abhi11796acharya/GHPowermon_new/Documents/progress-presentation/GHpowermonitoring.pdf

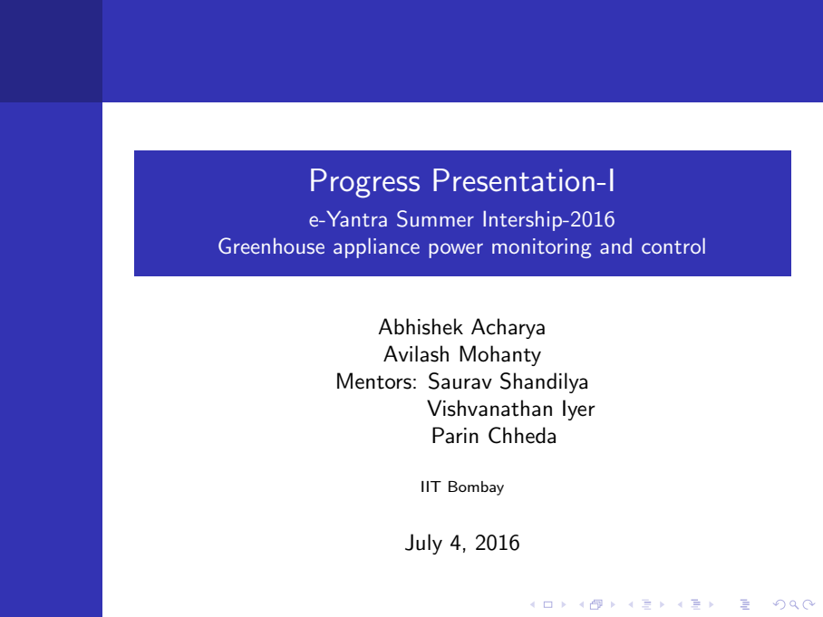
[picture p68: figure]
Progress Presentation-I; e-Yantra Summer Intership-2016; Abhishek Acharya Avilash Mohanty Mentors: Saurav Shandilya Vishvanathan Iyer Parin Chheda; IIT Bombay; July 4, 2016

# Greenhouse appliance power monitoring and control

Progress
Presentation-I

Abhishek
Acharya
Avilash Mohanty
Mentors: Saurav
Shandilya

Vishvanathan
Iyer

Parin Chheda

Overview of
Project

Overview of Task

Task Accomplised

Challenges Faced

Future Plans

References

Thank You

# Overview of Project

# Project Name: Greenhouse appliance power monitoring and control

# Objective: To develop a wifi enabled device which will measure and display the basic and derived inflow parameters of connected electrical appliance on the web page. Device should be capable

of turning on/off the electrical appliance from web user interface.

# Deliverables: A system which:

# Log and display measured electrical parameters on web server

and page.
control appliance from web user interface.

# schedule on/off time of appliance based on power consumption

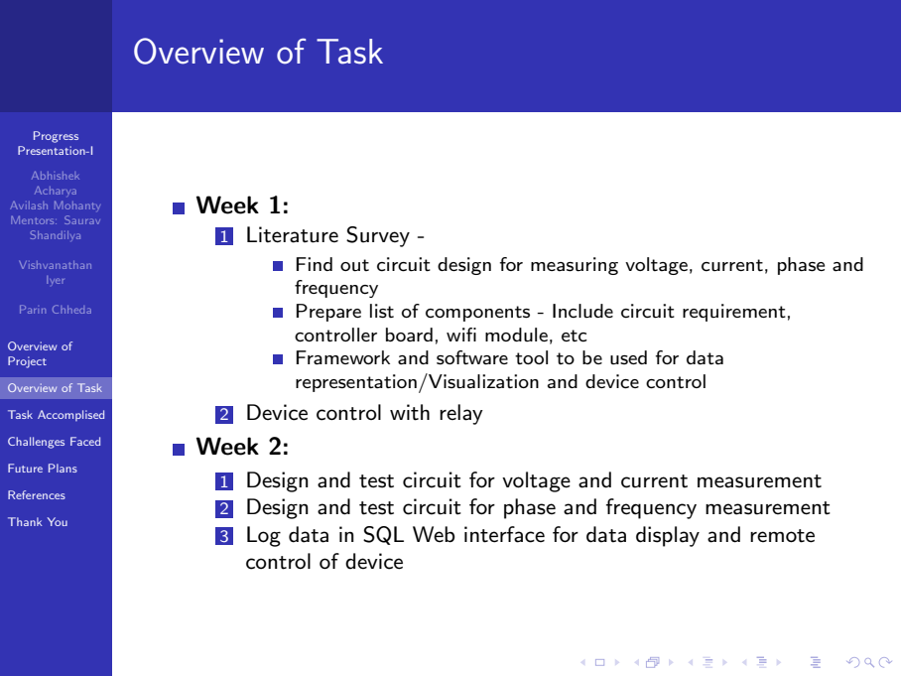
[picture p69: figure]
Progress Presentation-I; Abhishek Acharya Avilash Mohanty Mentors: Saurav Shandilya; Vishvanathan Iyer; Parin Chheda; Overview of Project; Overview of Task; Task Accomplised; Challenges Faced; Future Plans; References; Thank You; Week 1:; Literature Survey -; frequency; controller board, wifi module, etc; Device control with relay; Week 2:; control of device

## Find out circuit design for measuring voltage, current, phase and

Prepare list of components - Include circuit requirement,

## Framework and software tool to be used for data representation/Visualization and device control

1 | Design and test circuit for voltage and current measurement
2 | Design and test circuit for phase and frequency measurement
3 | Log data in SQL Web interface for data display and remote

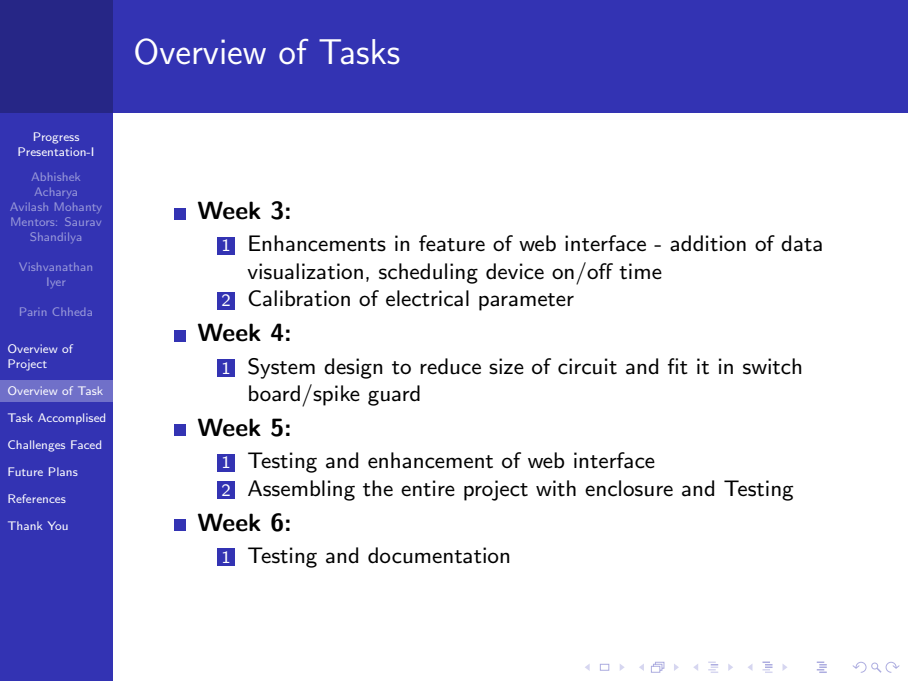
[picture p70: figure]
Progress Presentation-I; Abhishek Acharya Avilash Mohanty Mentors: Saurav Shandilya; Vishvanathan Iyer; Parin Chheda; Overview of Project; Overview of Task; Task Accomplised; Challenges Faced; Future Plans; References; Thank You; Overview of Tasks; Week 3:; Calibration of electrical parameter; Week 4:; board/spike guard; Week 5:; Week 6:; Testing and documentation

1 | Enhancements in feature of web interface - addition of data visualization, scheduling device on/off time
1 | System design to reduce size of circuit and fit it in switch
1 | Testing and enhancement of web interface
2 | Assembling the entire project with enclosure and Testing

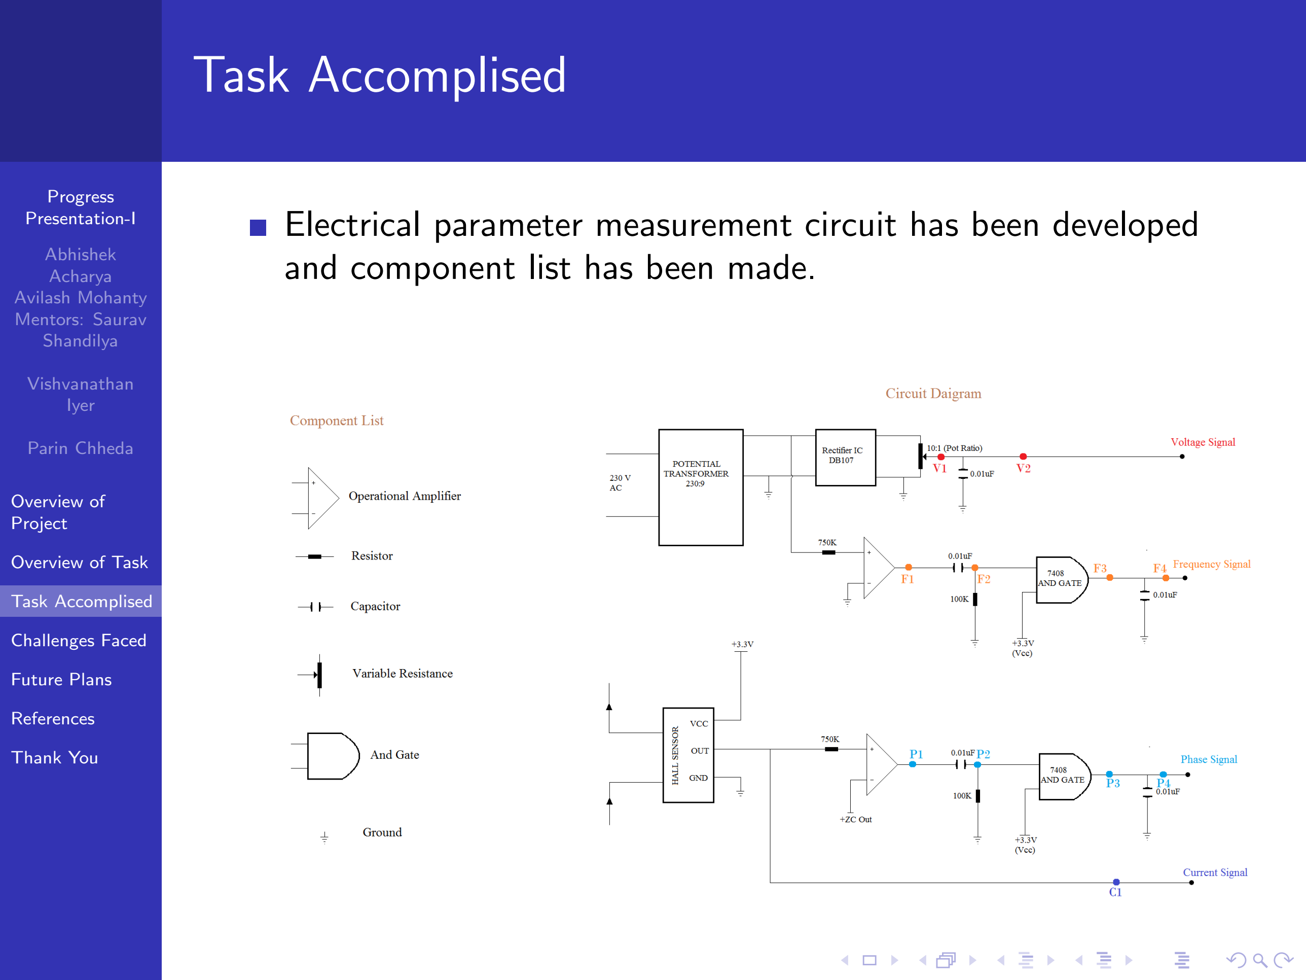
[picture p71: figure]
Progress Presentation-I; Abhishek Acharya Avilash Mohanty Mentors: Saurav Shandilya; Vishvanathan Iyer; Parin Chheda; Overview of Project; Overview of Task; Task Accomplised; Challenges Faced; Future Plans; References; Thank You; and component list has been made.

# Electrical parameter measurement circuit has been developed

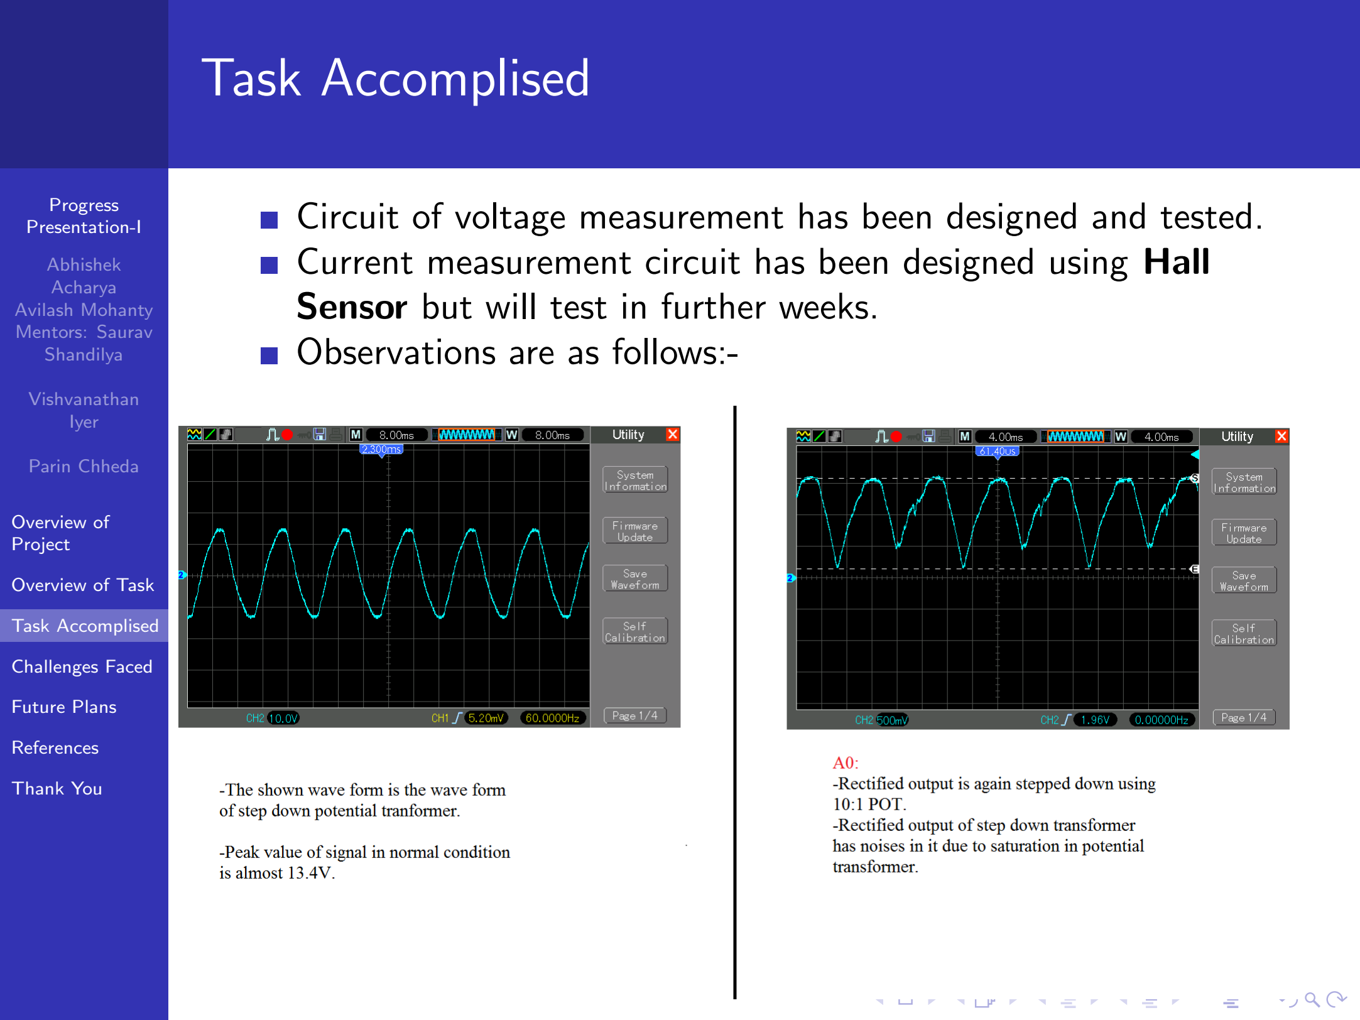
[picture p72: figure]
Progress Presentation-I; Abhishek Acharya Avilash Mohanty Mentors: Saurav Shandilya; Vishvanathan Iyer; Parin Chheda; Overview of Project; Overview of Task; Task Accomplised; Challenges Faced; Future Plans; References; Thank You; Sensor but will test in further weeks. Observations are as follows:-

Circuit of voltage measurement has been designed and tested.

# Current measurement circuit has been designed using Hall

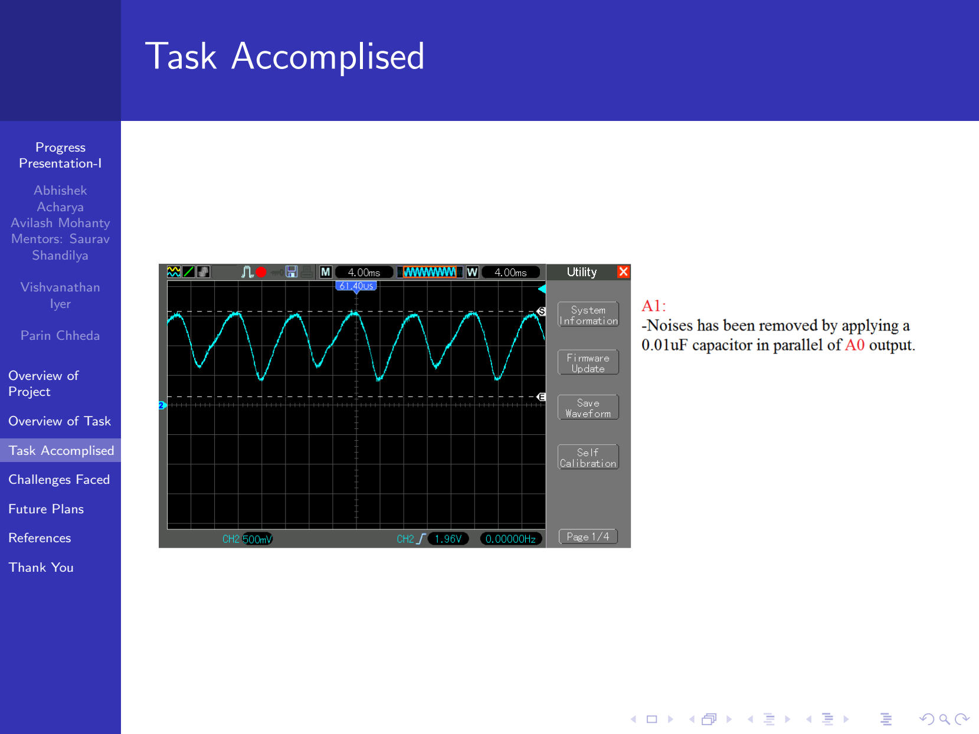
[picture p73: figure]
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

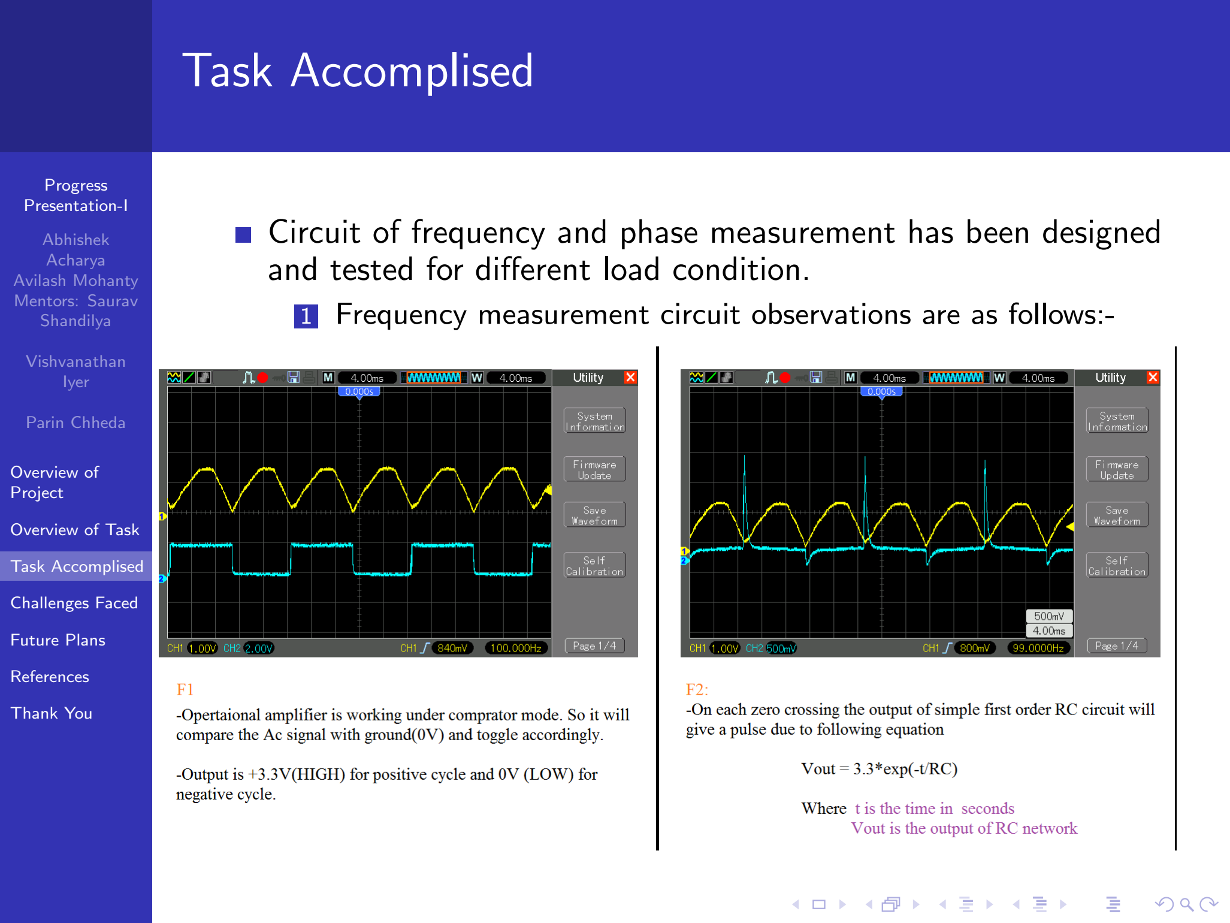
[picture p74: figure]
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

# Circuit of frequency and phase measurement has been designed

and tested for different load condition.

# 1 Frequency measurement circuit observations are as follows:-

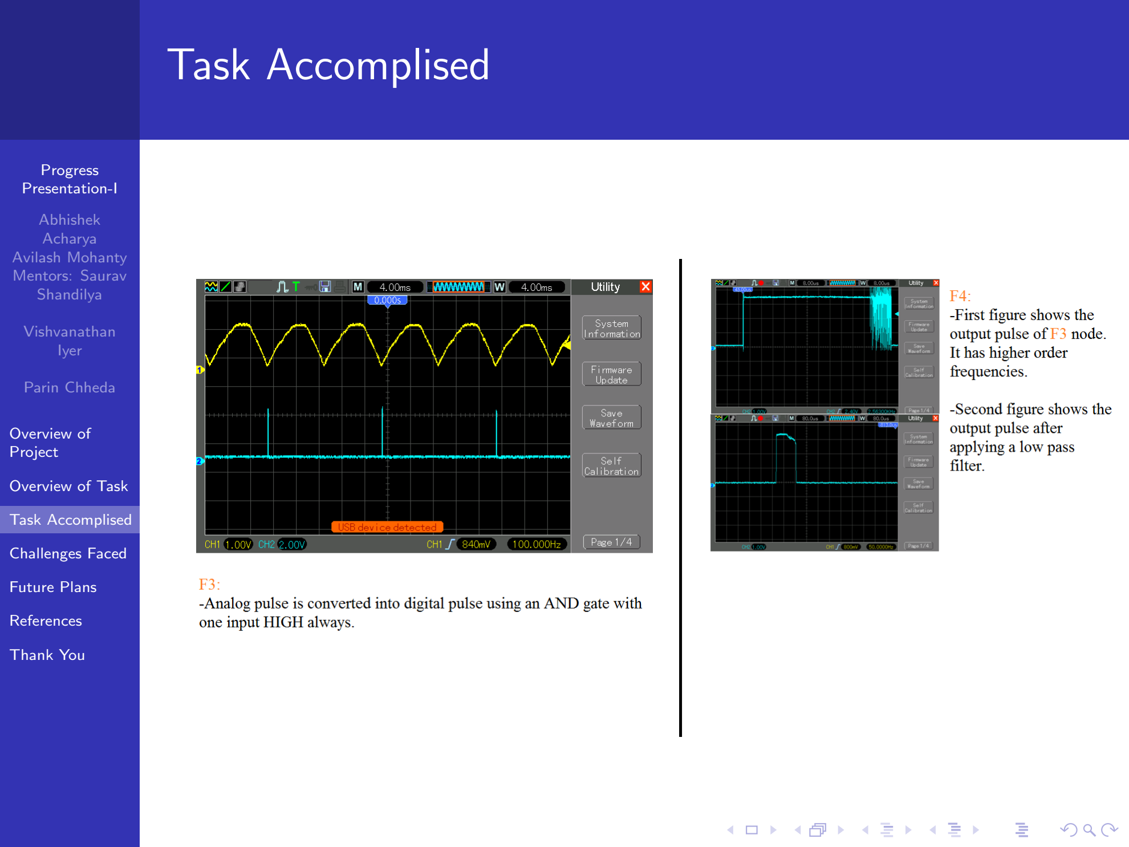
[picture p75: figure]
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

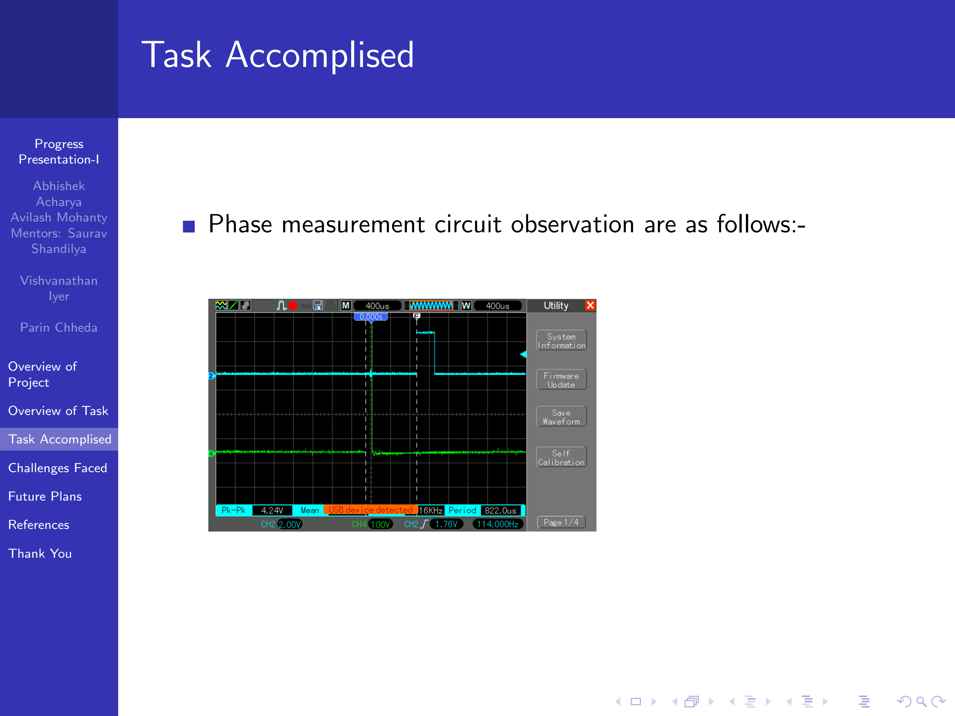
[picture p76: figure]
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

# Phase measurement circuit observation are as follows:-

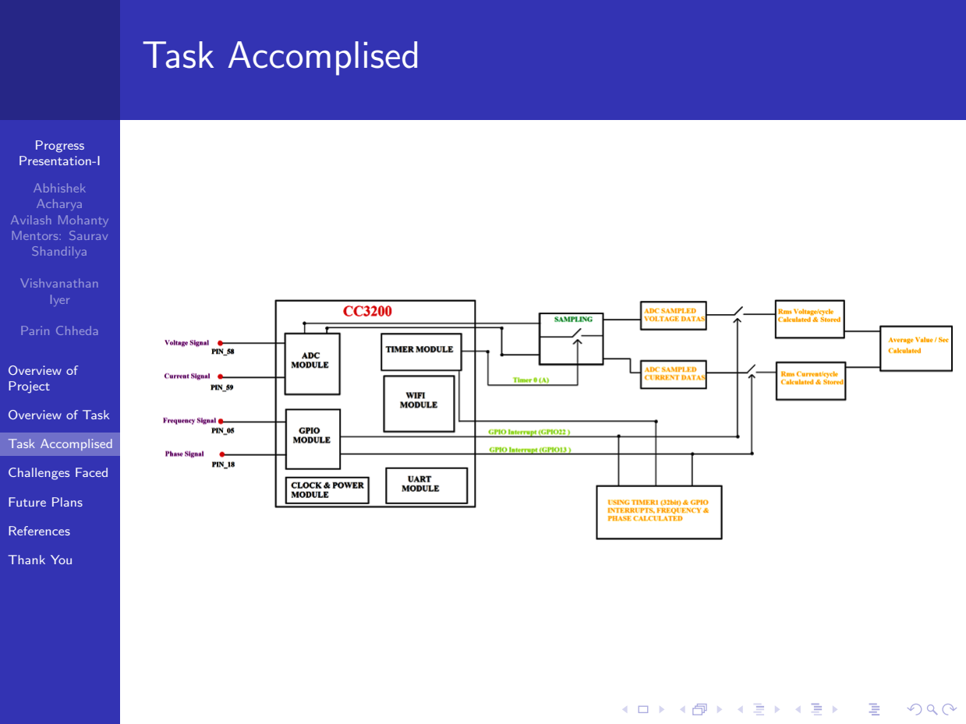
[picture p77: figure]
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

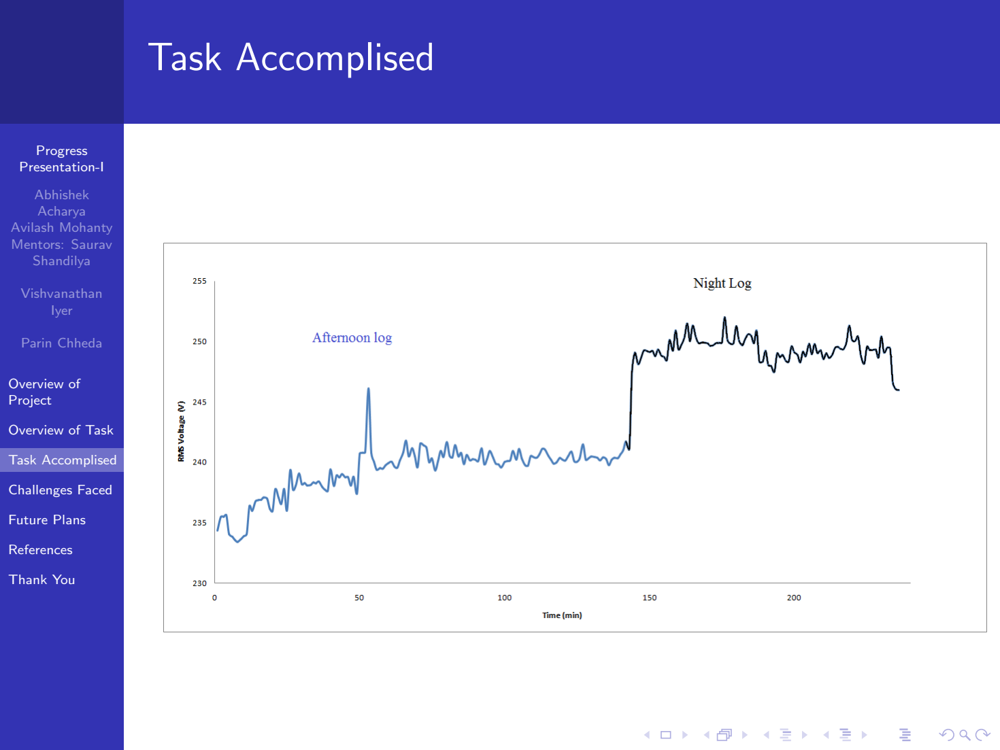
[picture p78: figure]
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

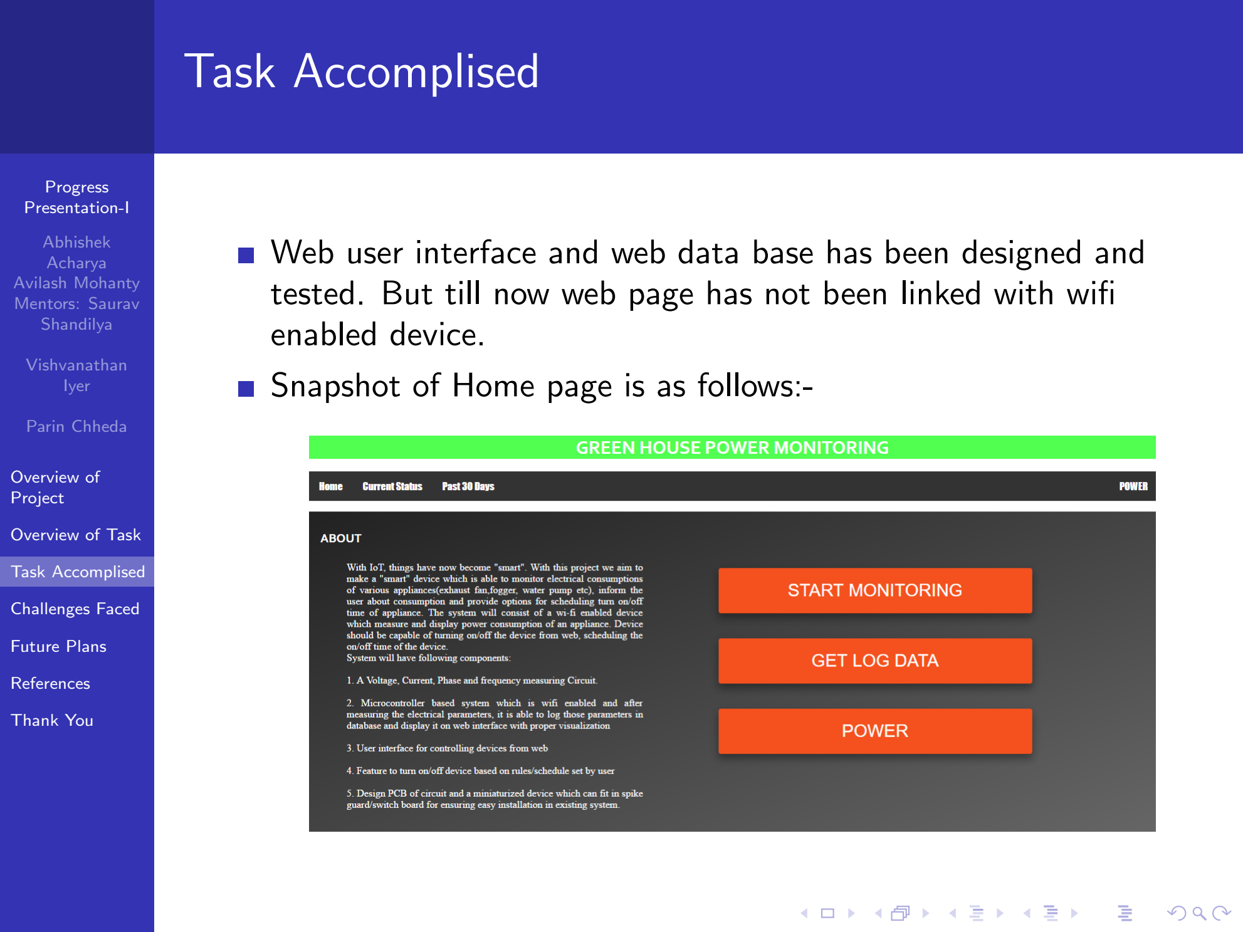
[picture p79: figure]
Progress Presentation-I; Abhishek Acharya Avilash Mohanty Mentors: Saurav Shandilya; Vishvanathan Iyer; Parin Chheda; Overview of Project; Overview of Task; Task Accomplised; Challenges Faced; Future Plans; References; Thank You; enabled device.; Snapshot of Home page is as follows:-

# Web user interface and web data base has been designed and tested. But till now web page has not been linked with wifi

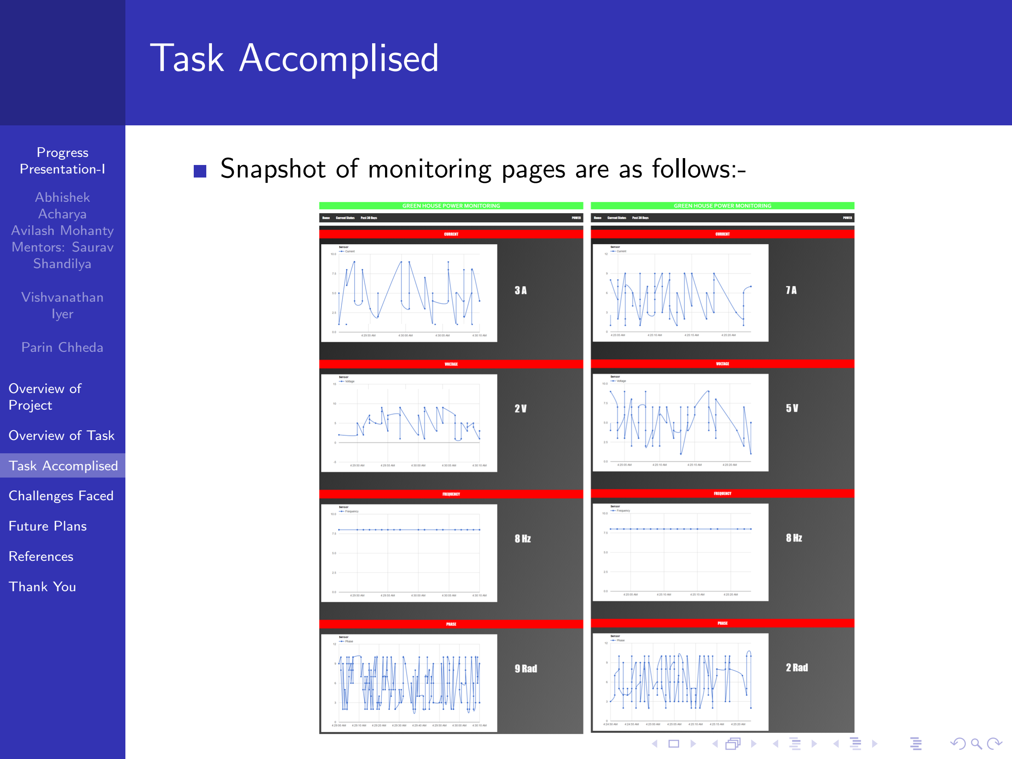
[picture p80: figure]
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

# Snapshot of monitoring pages are as follows:-

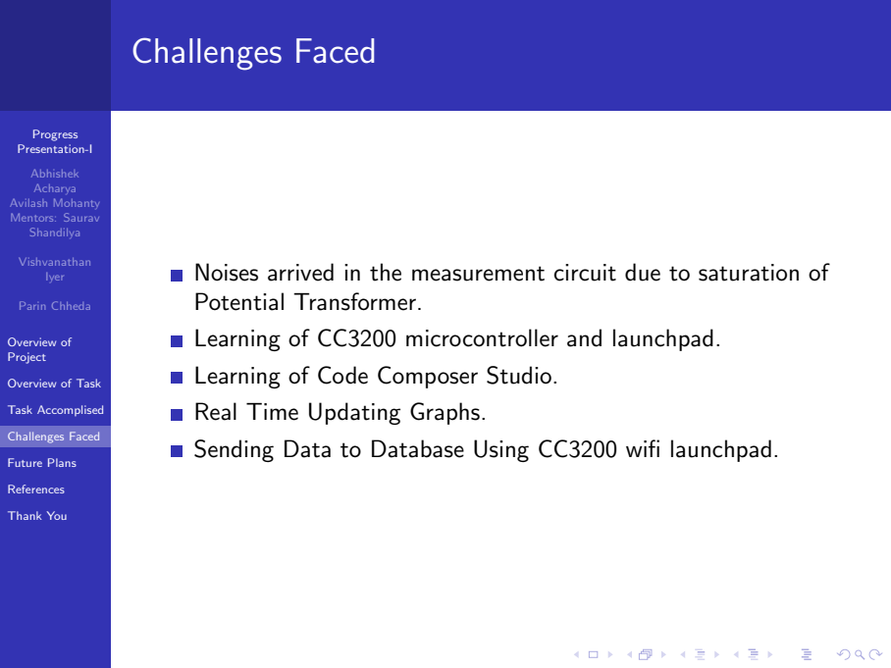
[picture p81: figure]
Progress Presentation-I; Abhishek Acharya Avilash Mohanty Mentors: Saurav Shandilya; Vishvanathan Iyer; Parin Chheda; Overview of Project; Overview of Task; Task Accomplised; Challenges Faced; Future Plans; References; Thank You; Potential Transformer.; Learning of Code Composer Studio.; Real Time Updating Graphs.

# Noises arrived in the measurement circuit due to saturation of

Learning of CC3200 microcontroller and launchpad.

Sending Data to Database Using CC3200 wifi launchpad.

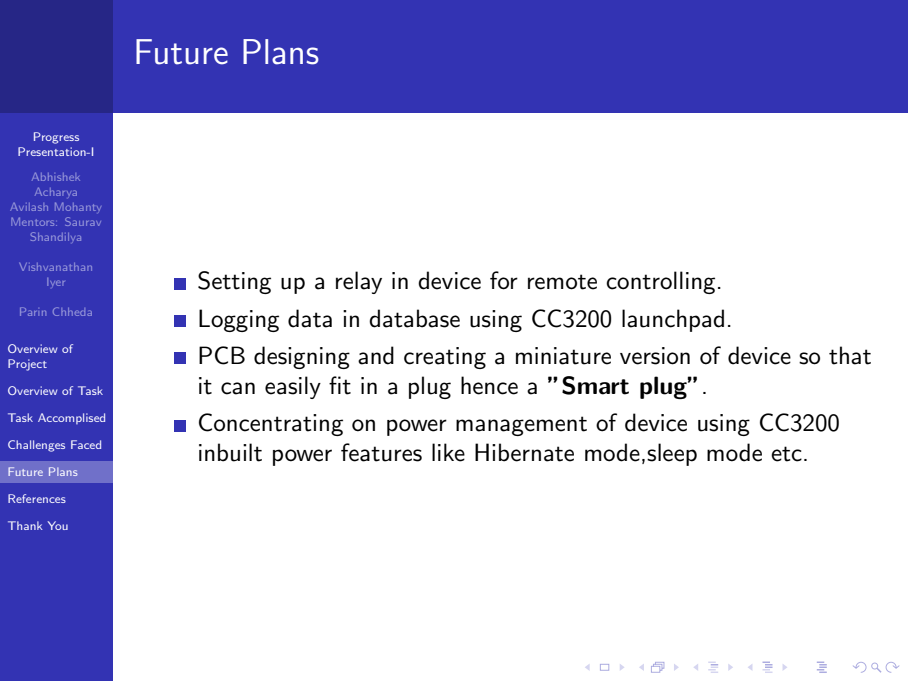
[picture p82: figure]
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

Setting up a relay in device for remote controlling.
Logging data in database using CC3200 launchpad.

# PCB designing and creating a miniature version of device so that

it can easily fit in a plug hence a ”Smart plug”.

# Concentrating on power management of device using CC3200

inbuilt power features like Hibernate mode,sleep mode etc.

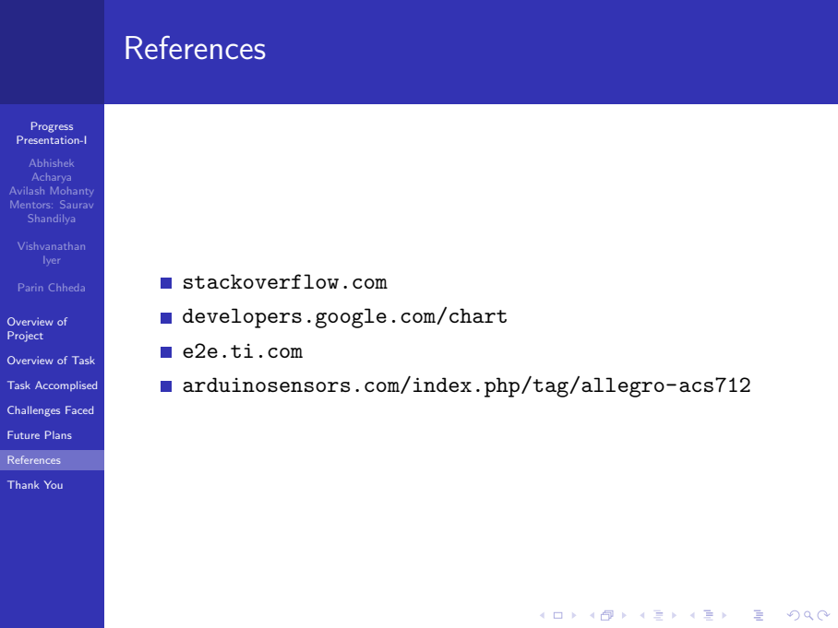
[picture p83: figure]
Progress Presentation-I; Abhishek Acharya Avilash Mohanty Mentors: Saurav Shandilya; Vishvanathan Iyer; Parin Chheda; Overview of Project; Overview of Task; Task Accomplised; Challenges Faced; Future Plans; References; Thank You; stackoverflow.com; developers.google.com/chart; e2e.ti.com

# arduinosensors.com/index.php/tag/allegro-acs712

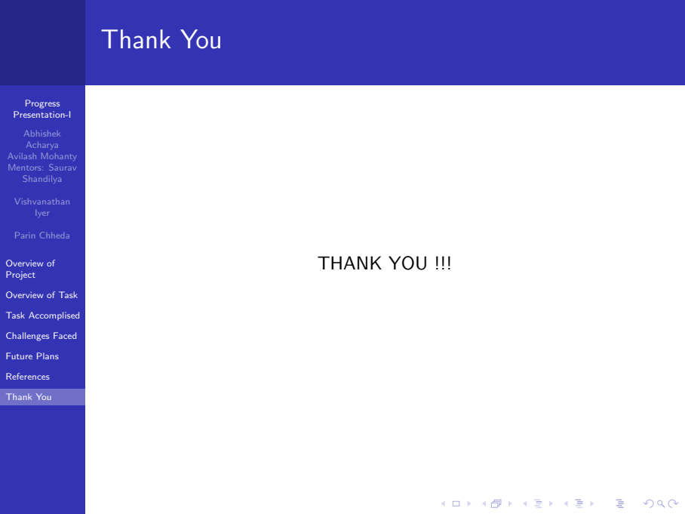
[picture p84: figure]
Progress Presentation-I; Abhishek Acharya Avilash Mohanty Mentors: Saurav Shandilya; Vishvanathan Iyer; Parin Chheda; Overview of Project; Overview of Task; Task Accomplised; Challenges Faced; Future Plans; References; Thank You; THANK YOU !!!
