abhi11796acharya/GHPowermon_new/Documents/progress-presentation/freq_circuit.png

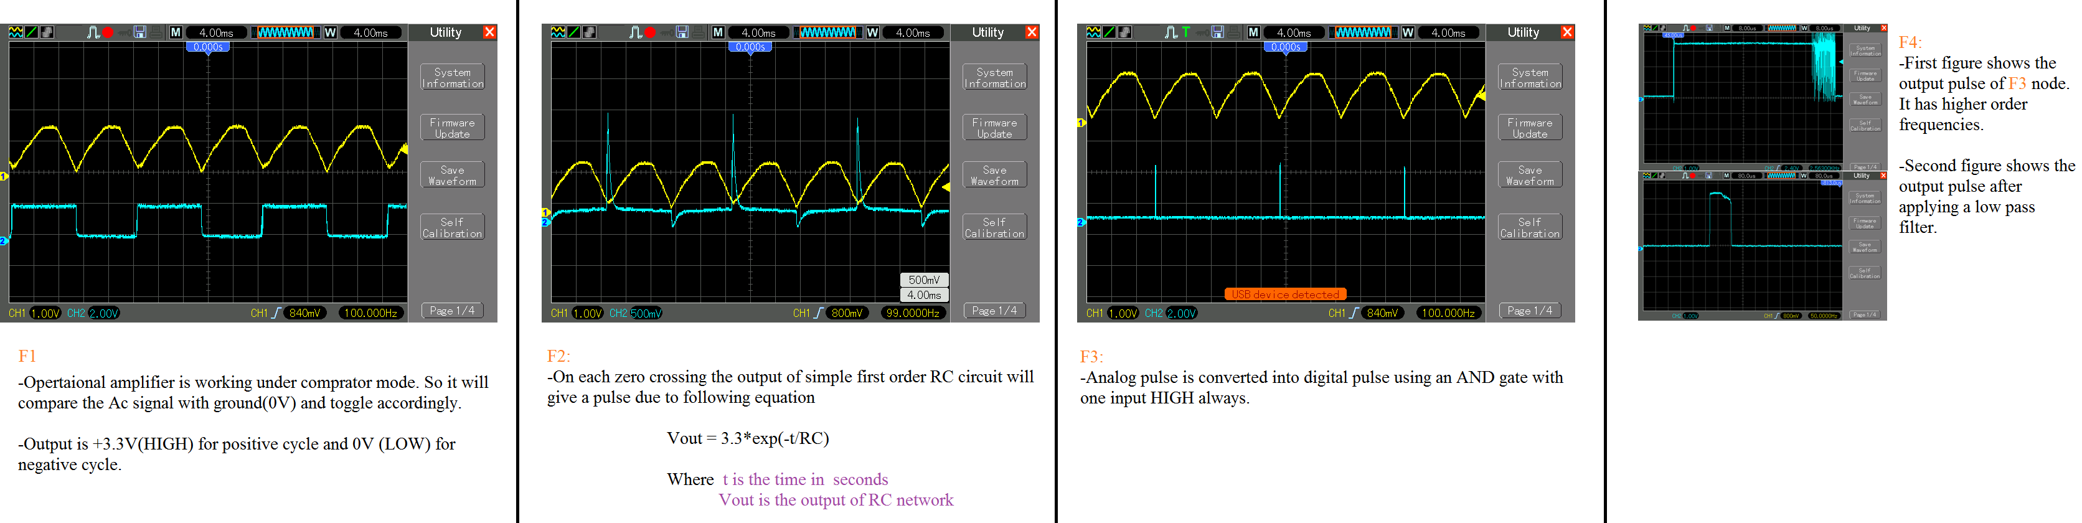
Documents/progress-presentation/freq_circuit.png
