abhi11796acharya/GHPowermon_new/Documents/report_eYSIP_GHpowerMonitoring/images/httpdconf.PNG

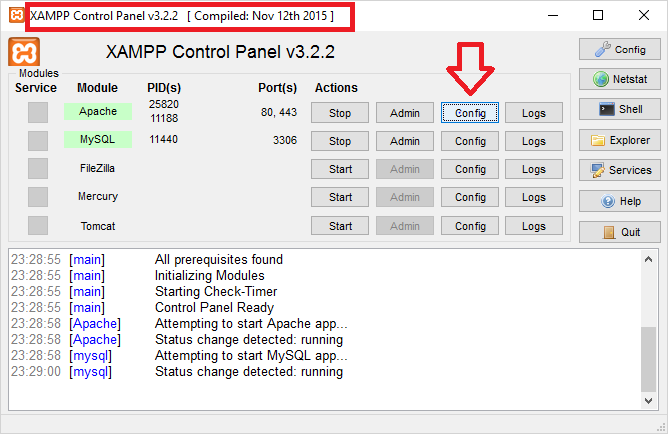
Documents/report_eYSIP_GHpowerMonitoring/images/httpdconf.PNG
