abhi11796acharya/GHPowermon_new/Documents/report_eYSIP_GHpowerMonitoring/images/inst17.JPG

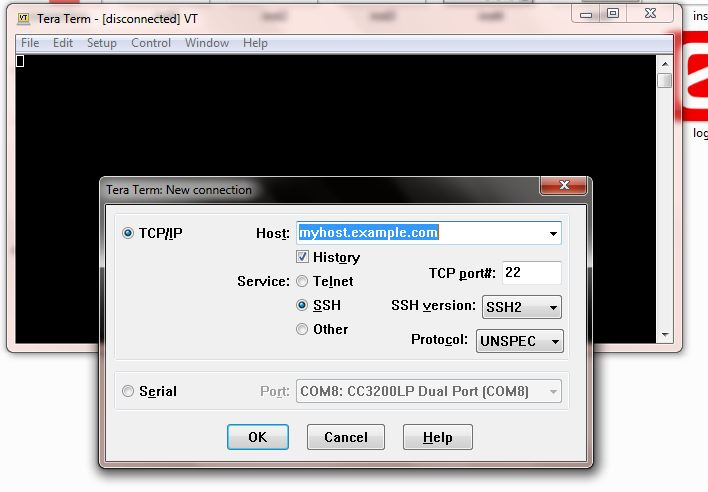
Documents/report_eYSIP_GHpowerMonitoring/images/inst17.JPG
