abhi11796acharya/GHPowermon_new/Documents/report_eYSIP_GHpowerMonitoring/images/logged1.png

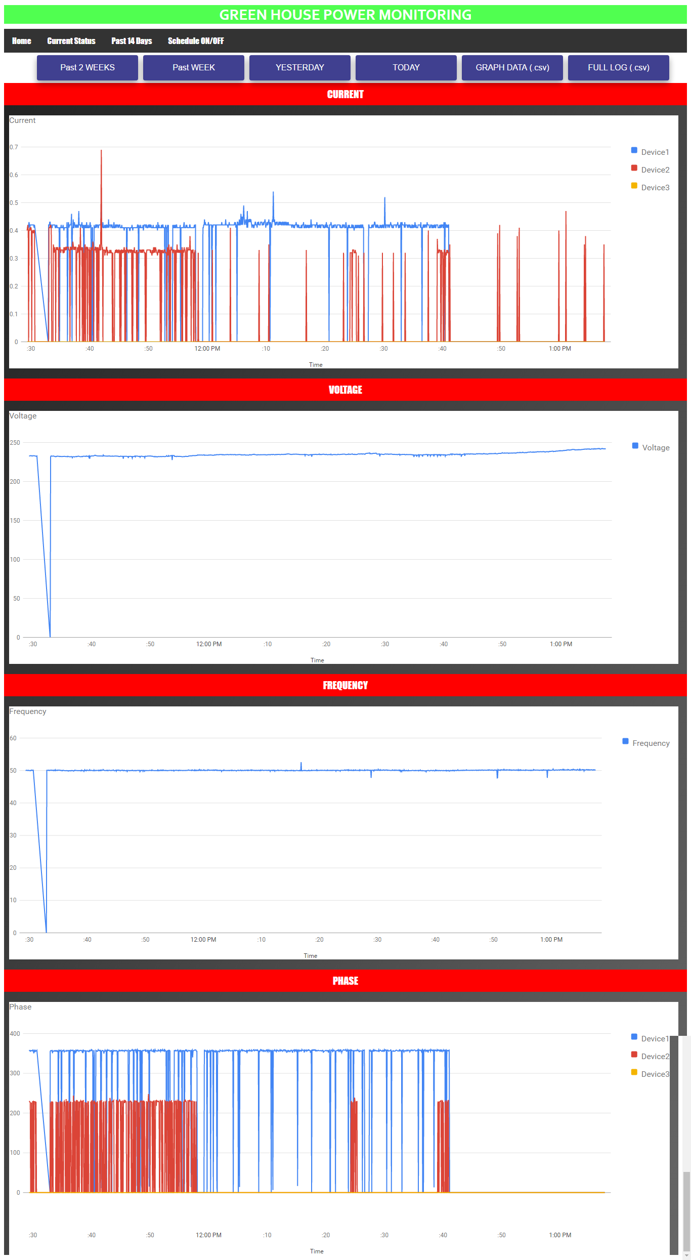
Documents/report_eYSIP_GHpowerMonitoring/images/logged1.png
