abhi11796acharya/GHPowermon_new/Documents/report_eYSIP_GHpowerMonitoring/images/logging_page_2.png

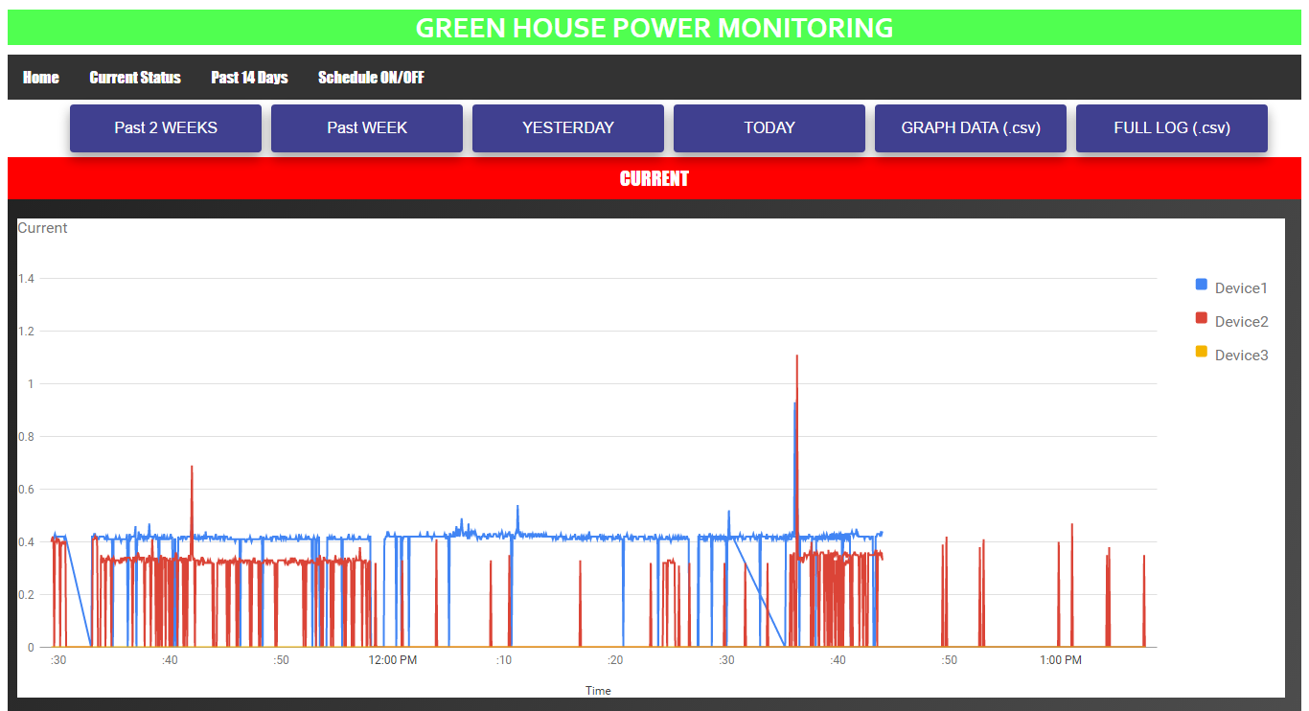
Documents/report_eYSIP_GHpowerMonitoring/images/logging_page_2.png
