abhi11796acharya/GHPowermon_new/Documents/report_eYSIP_GHpowerMonitoring/images/Scheduleonoff.png

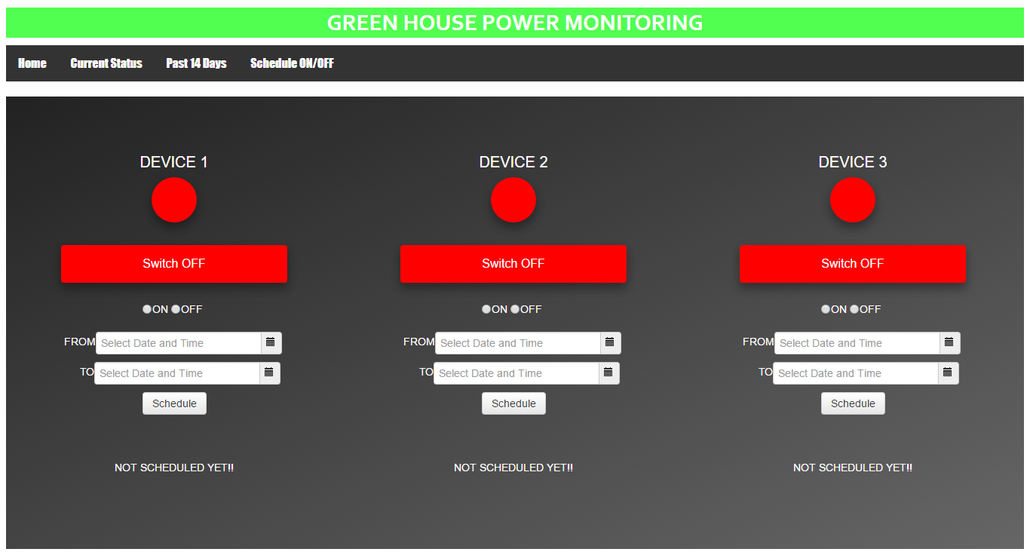
Documents/report_eYSIP_GHpowerMonitoring/images/Scheduleonoff.png
