abhi11796acharya/GHPowermon_new/Documents/report_eYSIP_GHpowerMonitoring/images/screencapture-localhost-GHpowermon-home-php-1469086565114.png

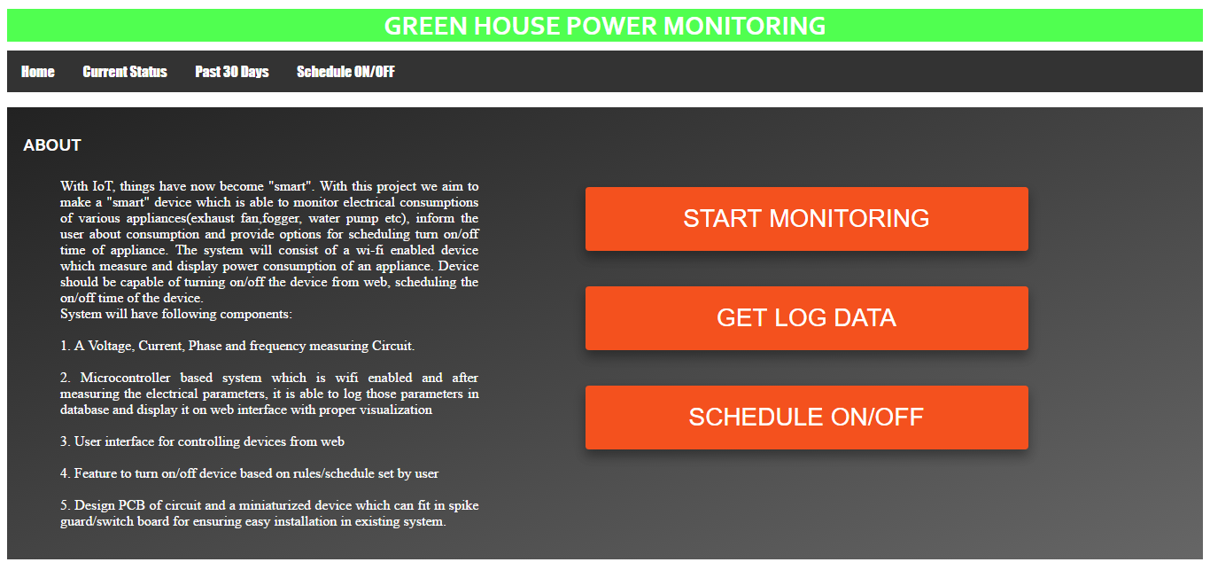
Documents/report_eYSIP_GHpowerMonitoring/images/screencapture-localhost-GHpowermon-home-php-1469086565114.png
