abhi11796acharya/GHPowermon_new/Documents/report_eYSIP_GHpowerMonitoring/images/xampp1.PNG

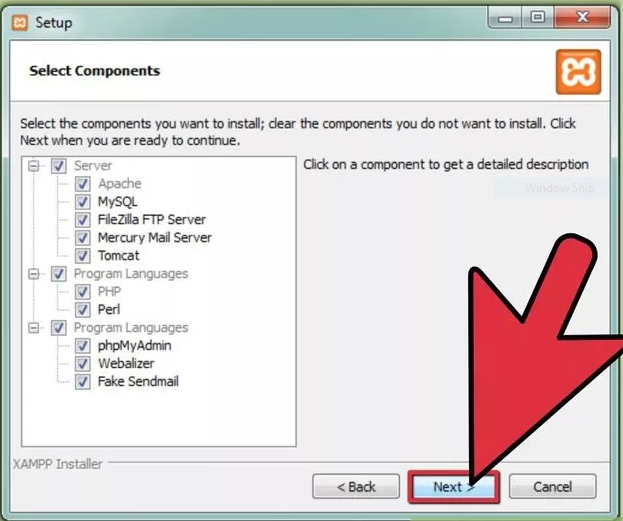
Documents/report_eYSIP_GHpowerMonitoring/images/xampp1.PNG
