abhi11796acharya/GHPowermon_new/Observations/Date 16-06-16/pic_546_2.bmp

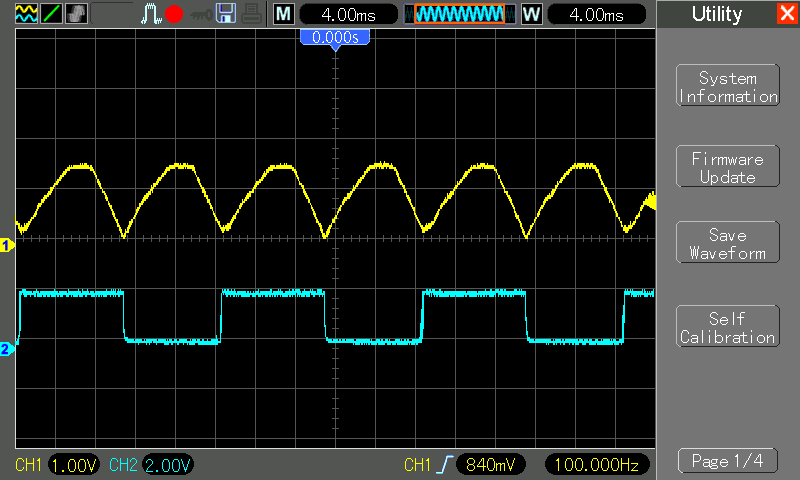
Observations/Date 16-06-16/pic_546_2.bmp
