abhi11796acharya/GHPowermon_new/Observations/Date 16-06-16/pic_547_1.bmp

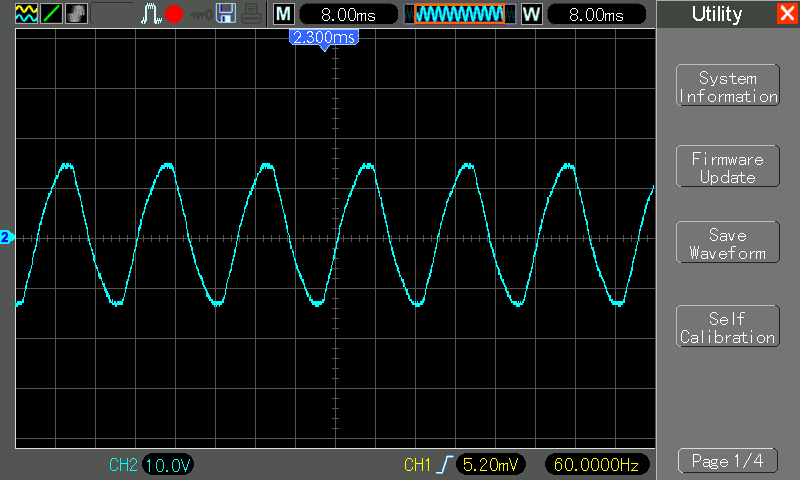
Observations/Date 16-06-16/pic_547_1.bmp
