abhi11796acharya/GHPowermon_new/Observations/Date 17-06-16/pic_554_1.bmp

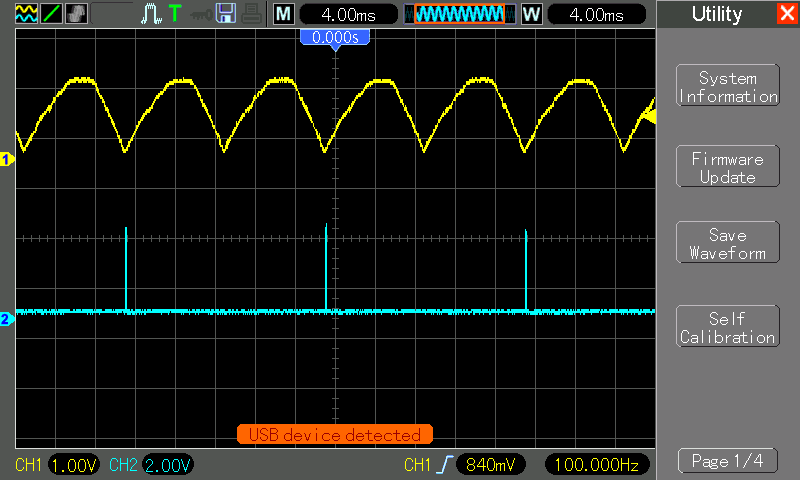
Observations/Date 17-06-16/pic_554_1.bmp
