abhi11796acharya/GHPowermon_new/Observations/Date 20-06-16/pic_555_3.bmp

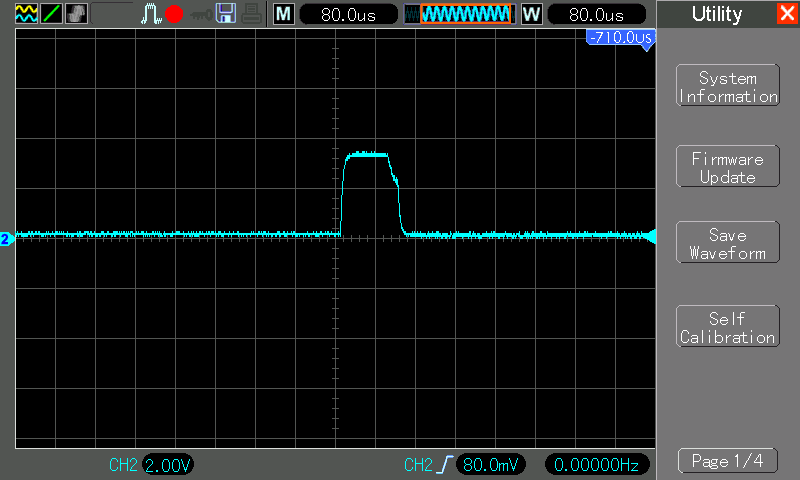
Observations/Date 20-06-16/pic_555_3.bmp
