abhi11796acharya/GHPowermon_new/Observations/Date 20-06-16/pic_559_2.bmp

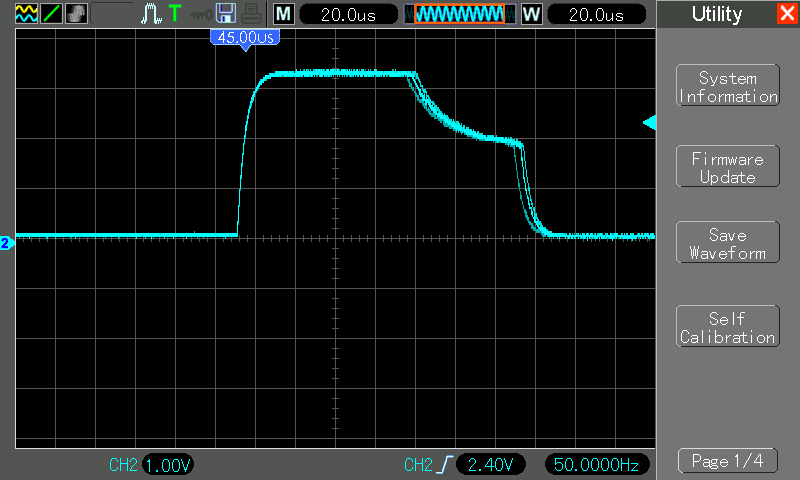
Observations/Date 20-06-16/pic_559_2.bmp
