abhi11796acharya/GHPowermon_new/Observations/Date 20-06-16/pic_568_4.bmp

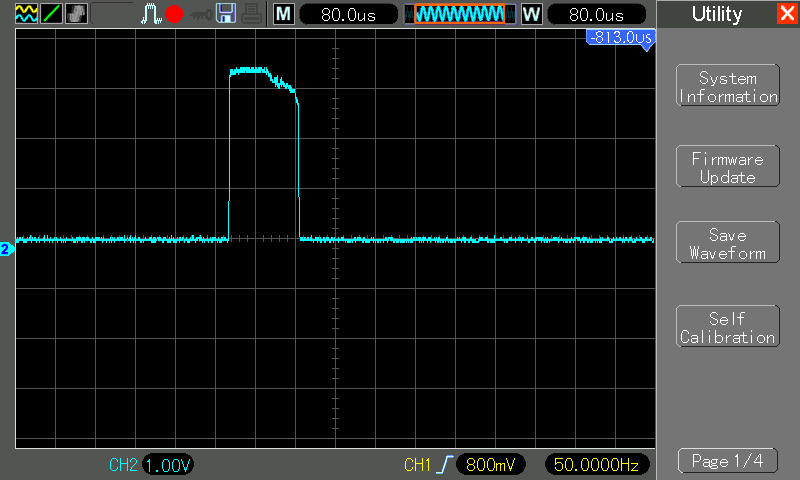
Observations/Date 20-06-16/pic_568_4.bmp
