abhi11796acharya/GHPowermon_new/Observations/Date 21-06-16/pic_574_2.bmp

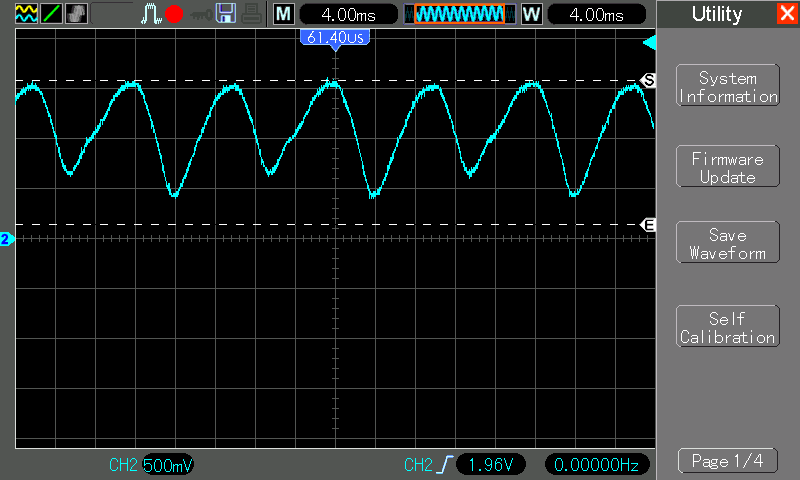
Observations/Date 21-06-16/pic_574_2.bmp
