abhi11796acharya/GHPowermon_new/Observations/Date 22-06-15/pic_599_1.bmp

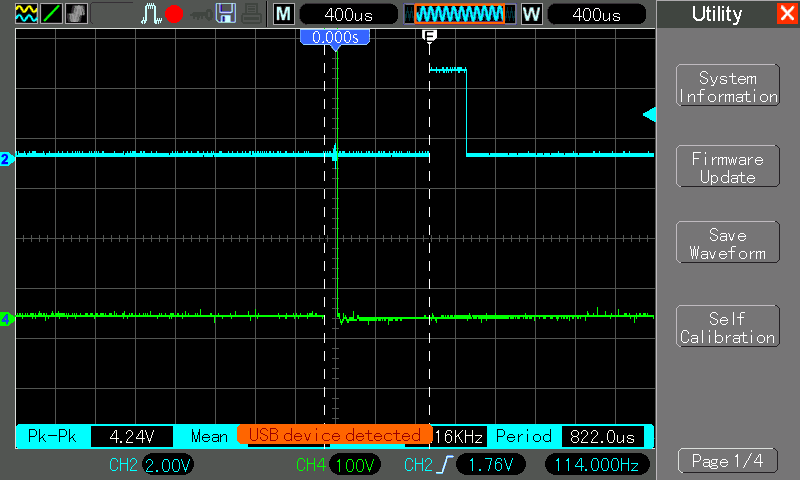
Observations/Date 22-06-15/pic_599_1.bmp
