abhi11796acharya/GHPowermon_new/Softwares and Codes/Device code/GHpower-ccs (Test Versions)/TcfTransactionLog.csv

Service | Message | Max | Min | Average | Count | frequency | TimedOut
Stream | setLogBits | 672.5104 | 672.5104 | 672.5104 | 1 | 0
