abhi11796acharya/GHPowermon_new/(list of files, drawings)

Other design files:
PCB and Schematic/PCB.fzz
PCB and Schematic/Schematic file.fzz
