abhi11796acharya/GHPowermon_new/Softwares and Codes/Device code/GHpower-ccs (Test Versions)/startup_ccs.c

//*****************************************************************************
// startup_ccs.c
//
// Startup code for use with TI's Code Composer Studio.
//
// Copyright (C) 2014 Texas Instruments Incorporated - http://www.ti.com/ 
// 
// 
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
//    Redistributions of source code must retain the above copyright 
//    notice, this list of conditions and the following disclaimer.
//
//    Redistributions in binary form must reproduce the above copyright
//    notice, this list of conditions and the following disclaimer in the 
//    documentation and/or other materials provided with the   
//    distribution.
//
//    Neither the name of Texas Instruments Incorporated nor the names of
//    its contributors may be used to endorse or promote products derived
//    from this software without specific prior written permission.
//
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
//*****************************************************************************

//*****************************************************************************
//
// Forward declaration of the default fault handlers.
//
//*****************************************************************************
void ResetISR(void);
static void NmiSR(void);
static void FaultISR(void);
static void IntDefaultHandler(void);
static void BusFaultHandler(void);
//*****************************************************************************
//
// External declaration for the reset handler that is to be called when the
// processor is started
//
//*****************************************************************************
extern void _c_int00(void);
extern void INT_1(void);
extern void INT_2(void);
extern void TIMER0A_INT(void);

//*****************************************************************************
//
// Linker variable that marks the top of the stack.
//
//*****************************************************************************
extern unsigned long __STACK_END;

//*****************************************************************************
// The vector table.  Note that the proper constructs must be placed on this to
// ensure that it ends up at physical address 0x0000.0000 or at the start of
// the program if located at a start address other than 0.
//
//*****************************************************************************
#pragma DATA_SECTION(g_pfnVectors, ".intvecs")
void (* const g_pfnVectors[])(void) =
{
    (void (*)(void))((unsigned long)&__STACK_END),
                                            // The initial stack pointer
    ResetISR,                               // The reset handler
    NmiSR,                                  // The NMI handler
    FaultISR,                               // The hard fault handler
    IntDefaultHandler,                      // The MPU fault handler
    BusFaultHandler,                        // The bus fault handler
    IntDefaultHandler,                      // The usage fault handler
    0,                                      // Reserved
    0,                                      // Reserved
    0,                                      // Reserved
    0,                                      // Reserved
    IntDefaultHandler,                      // SVCall handler
    IntDefaultHandler,                      // Debug monitor handler
    0,                                      // Reserved
    IntDefaultHandler,                      // The PendSV handler
    IntDefaultHandler,                      // The SysTick handler
    IntDefaultHandler,                      // GPIO Port A0
    INT_1,                                  // GPIO Port A1
	IntDefaultHandler,           			// GPIO Port A2
    INT_2,			            	        // GPIO Port A3
    0,                                      // Reserved
    IntDefaultHandler,                      // UART0 Rx and Tx
    IntDefaultHandler,                      // UART1 Rx and Tx
    0,                                      // Reserved
    IntDefaultHandler,                      // I2C0 Master and Slave
    0,0,0,0,0,                              // Reserved
    IntDefaultHandler,                      // ADC Channel 0
    IntDefaultHandler,                      // ADC Channel 1
    IntDefaultHandler,                      // ADC Channel 2
    IntDefaultHandler,                      // ADC Channel 3
    IntDefaultHandler,                      // Watchdog Timer
    TIMER0A_INT,           		            // Timer 0 subtimer A
    IntDefaultHandler,                      // Timer 0 subtimer B
    IntDefaultHandler,                      // Timer 1 subtimer A
    IntDefaultHandler,                      // Timer 1 subtimer B
    IntDefaultHandler,                      // Timer 2 subtimer A
    IntDefaultHandler,                      // Timer 2 subtimer B 
    0,0,0,0,                                // Reserved
    IntDefaultHandler,                      // Flash
    0,0,0,0,0,                              // Reserved
    IntDefaultHandler,                      // Timer 3 subtimer A
    IntDefaultHandler,                      // Timer 3 subtimer B
    0,0,0,0,0,0,0,0,0,                      // Reserved
    IntDefaultHandler,                      // uDMA Software Transfer
    IntDefaultHandler,                      // uDMA Error
    0,0,0,0,0,0,0,0,0,0,                    // Reserved
    0,0,0,0,0,0,0,0,0,0,                    // Reserved
    0,0,0,0,0,0,0,0,0,0,                    // Reserved
    0,0,0,0,0,0,0,0,0,0,                    // Reserved
    0,0,0,0,0,0,0,0,0,0,                    // Reserved
    0,0,0,0,0,0,0,0,0,0,                    // Reserved
    0,0,0,0,0,0,0,0,0,0,                    // Reserved
    0,0,0,0,0,0,0,0,0,0,                    // Reserved
    0,0,0,0,0,0,0,0,0,0,                    // Reserved
    0,0,0,0,0,0,0,0,0,0,                    // Reserved
    IntDefaultHandler,                      // SHA
    0,0,                                    // Reserved
    IntDefaultHandler,                      // AES
    0,                                      // Reserved
    IntDefaultHandler,                      // DES
    0,0,0,0,0,                              // Reserved
    IntDefaultHandler,                      // SDHost
    0,                                      // Reserved
    IntDefaultHandler,                      // I2S
    0,                                      // Reserved
    IntDefaultHandler,                      // Camera
    0,0,0,0,0,0,0,                          // Reserved
    IntDefaultHandler,                      // NWP to APPS Interrupt
    IntDefaultHandler,                      // Power, Reset and Clock module
    0,0,                                    // Reserved
    IntDefaultHandler,                      // Shared SPI
    IntDefaultHandler,                      // Generic SPI
    IntDefaultHandler,                      // Link SPI
};

//*****************************************************************************
//
// This is the code that gets called when the processor first starts execution
// following a reset event.  Only the absolutely necessary set is performed,
// after which the application supplied entry() routine is called.  Any fancy
// actions (such as making decisions based on the reset cause register, and
// resetting the bits in that register) are left solely in the hands of the
// application.
//
//*****************************************************************************
void
ResetISR(void)
{
    //
    // Jump to the CCS C initialization routine.
    //
    __asm("    .global _c_int00\n"
          "    b.w     _c_int00");
}

//*****************************************************************************
//
// This is the code that gets called when the processor receives a NMI.  This
// simply enters an infinite loop, preserving the system state for examination
// by a debugger.
//
//*****************************************************************************
static void
NmiSR(void)
{
    //
    // Enter an infinite loop.
    //
    while(1)
    {
    }
}

//*****************************************************************************
//
// This is the code that gets called when the processor receives a fault
// interrupt.  This simply enters an infinite loop, preserving the system state
// for examination by a debugger.
//
//*****************************************************************************
static void
FaultISR(void)
{
    //
    // Enter an infinite loop.
    //
    while(1)
    {
    }
}

//*****************************************************************************
//
// This is the code that gets called when the processor receives an unexpected
// interrupt.  This simply enters an infinite loop, preserving the system state
// for examination by a debugger.
//
//*****************************************************************************


static void
BusFaultHandler(void)
{
    //
    // Go into an infinite loop.
    //
    while(1)
    {
    }
}

//*****************************************************************************
//
// This is the code that gets called when the processor receives an unexpected
// interrupt.  This simply enters an infinite loop, preserving the system state
// for examination by a debugger.
//
//*****************************************************************************
static void
IntDefaultHandler(void)
{
    //
    // Go into an infinite loop.
    //
    while(1)
    {
    }
}
