abhi11796acharya/GHPowermon_new/(commit log)

2016-06-28 ccs code
    [TcfTransactionLog.csv]
2016-07-06 Data log (06-07-2016 17:28-16:12)
    [reading.csv]
2016-07-06 button status
2016-07-07 Backend Files Updated
    [log.csv, reading.csv]
2016-07-12 Test files updated
    [log.csv, reading.csv]
2016-07-12 Button/Scheduler Overrider
    [reading.csv]
2016-07-15 VERSION 1
    With 3 Device support
    [reading.csv]
2016-07-16 VERSION 2 Functional
    [log.csv, reading.csv]
2016-07-18 VERSION 2 Testing
    [log.csv, reading.csv]
2016-07-23 report has been added
    [PCB.fzz, Schematic file.fzz]
2016-07-23 Final folder structure and report
    [PCB.fzz, Schematic file.fzz, TcfTransactionLog.csv, log.csv, reading.csv]
2016-07-23 minor updates
    [TcfTransactionLog.csv, log.csv, reading (2).csv, reading.csv]
2016-07-23 Renaming folders
    [TcfTransactionLog.csv]
